ZuzannaBran/SeedIoT/codebase/seediot-ui/assets/images/farmer/farmer-login.png

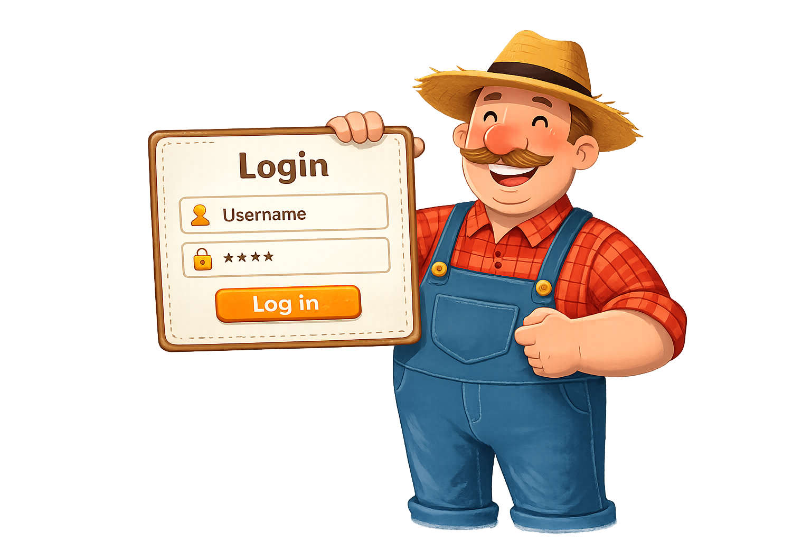
codebase/seediot-ui/assets/images/farmer/farmer-login.png
