ZuzannaBran/SeedIoT/codebase/seediot-ui/assets/images/bg/farm.jpg

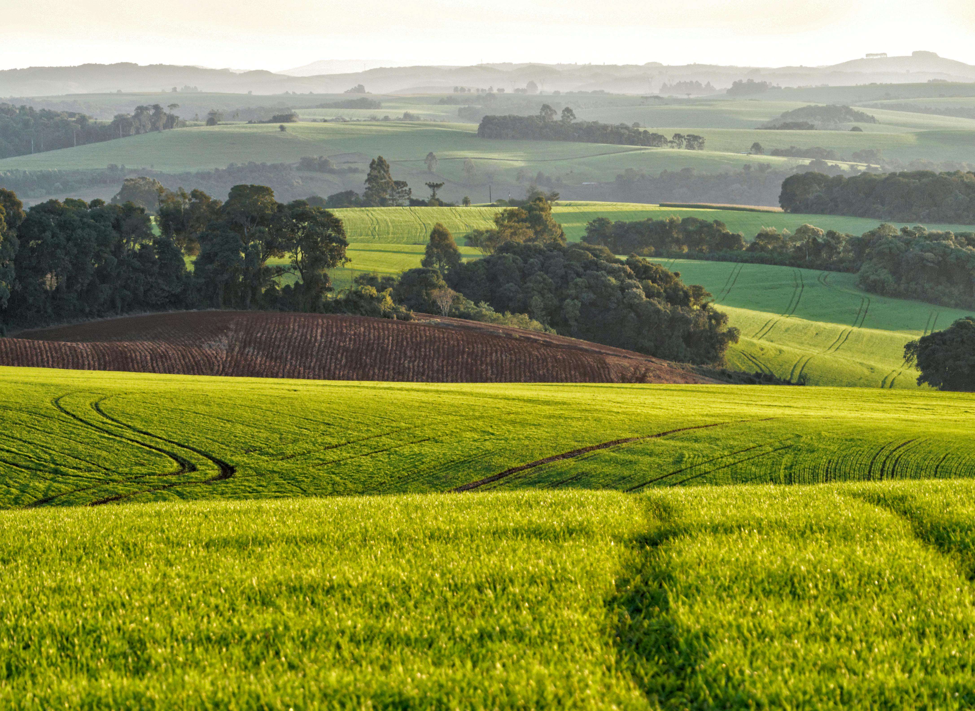
codebase/seediot-ui/assets/images/bg/farm.jpg
