ZuzannaBran/SeedIoT/codebase/seediot-ui/assets/images/qr/station-67-qr.png

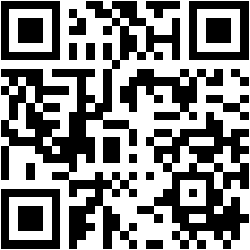
codebase/seediot-ui/assets/images/qr/station-67-qr.png
