ZuzannaBran/SeedIoT/(list of files, cad)

Other CAD files:
druk3d/Czujniki-SeedIoT.f3d
druk3d/Kolce-SeedIoT.f3d
druk3d/Stojak-SeedIoT.f3d
druk3d/UchwytNaCzujniki-SeedIoT.f3d
