ZuzannaBran/SeedIoT/codebase/rpi-code/sensor_pins.py

I2C_BUS_ID = 0
I2C_SDA_PIN = 4
I2C_SCL_PIN = 5
I2C_FREQ = 100000
ENVIRO_I2C_FREQ = 100000

LCD_I2C_ADDRESS = 0x27
LCD_I2C_BUS_ID = 0
LCD_I2C_SDA_PIN = 4
LCD_I2C_SCL_PIN = 5
LCD_I2C_FREQ = 100000

ENVIRO_RTC_I2C_ADDRESS = 0x51
ENVIRO_HOLD_VSYS_EN_PIN = 2
ENVIRO_EXTERNAL_INTERRUPT_PIN = 3
ENVIRO_ACTIVITY_LED_PIN = 6
ENVIRO_RTC_ALARM_PIN = 8

LTR559_I2C_ADDRESS = 0x23
BME280_I2C_ADDRESS = 0x77
BME680_I2C_ADDRESS = 0x77
SCD41_I2C_ADDRESS = 0x62

SCD41_I2C_BUS_ID = 0
SCD41_I2C_SDA_PIN = 4
SCD41_I2C_SCL_PIN = 5
SCD41_I2C_FREQ = 100000

BME680_USE_SOFT_I2C = True
BME680_I2C_BUS_ID = 0
BME680_I2C_SDA_PIN = 11
BME680_I2C_SCL_PIN = 12
BME680_I2C_FREQ = 100000

SOIL_MOISTURE_ADC_PIN = 27
SOIL_MOISTURE_DRY_VALUE = 1800
SOIL_MOISTURE_WET_VALUE = 58000
SOIL_MOISTURE_REFERENCE_VOLTAGE = 3.3

DS18B20_PIN = 28

WIND_SPEED_PIN = 9
RAIN_GAUGE_PIN = 10
WIND_DIRECTION_ADC_PIN = 26
